jer-lil/relay-bypass/relay-bypass-single-jack/relay-bypass-single-jack.kicad_pcb

## KiCad design relay-bypass-single-jack/relay-bypass-single-jack.kicad_pcb (2026-01-04)

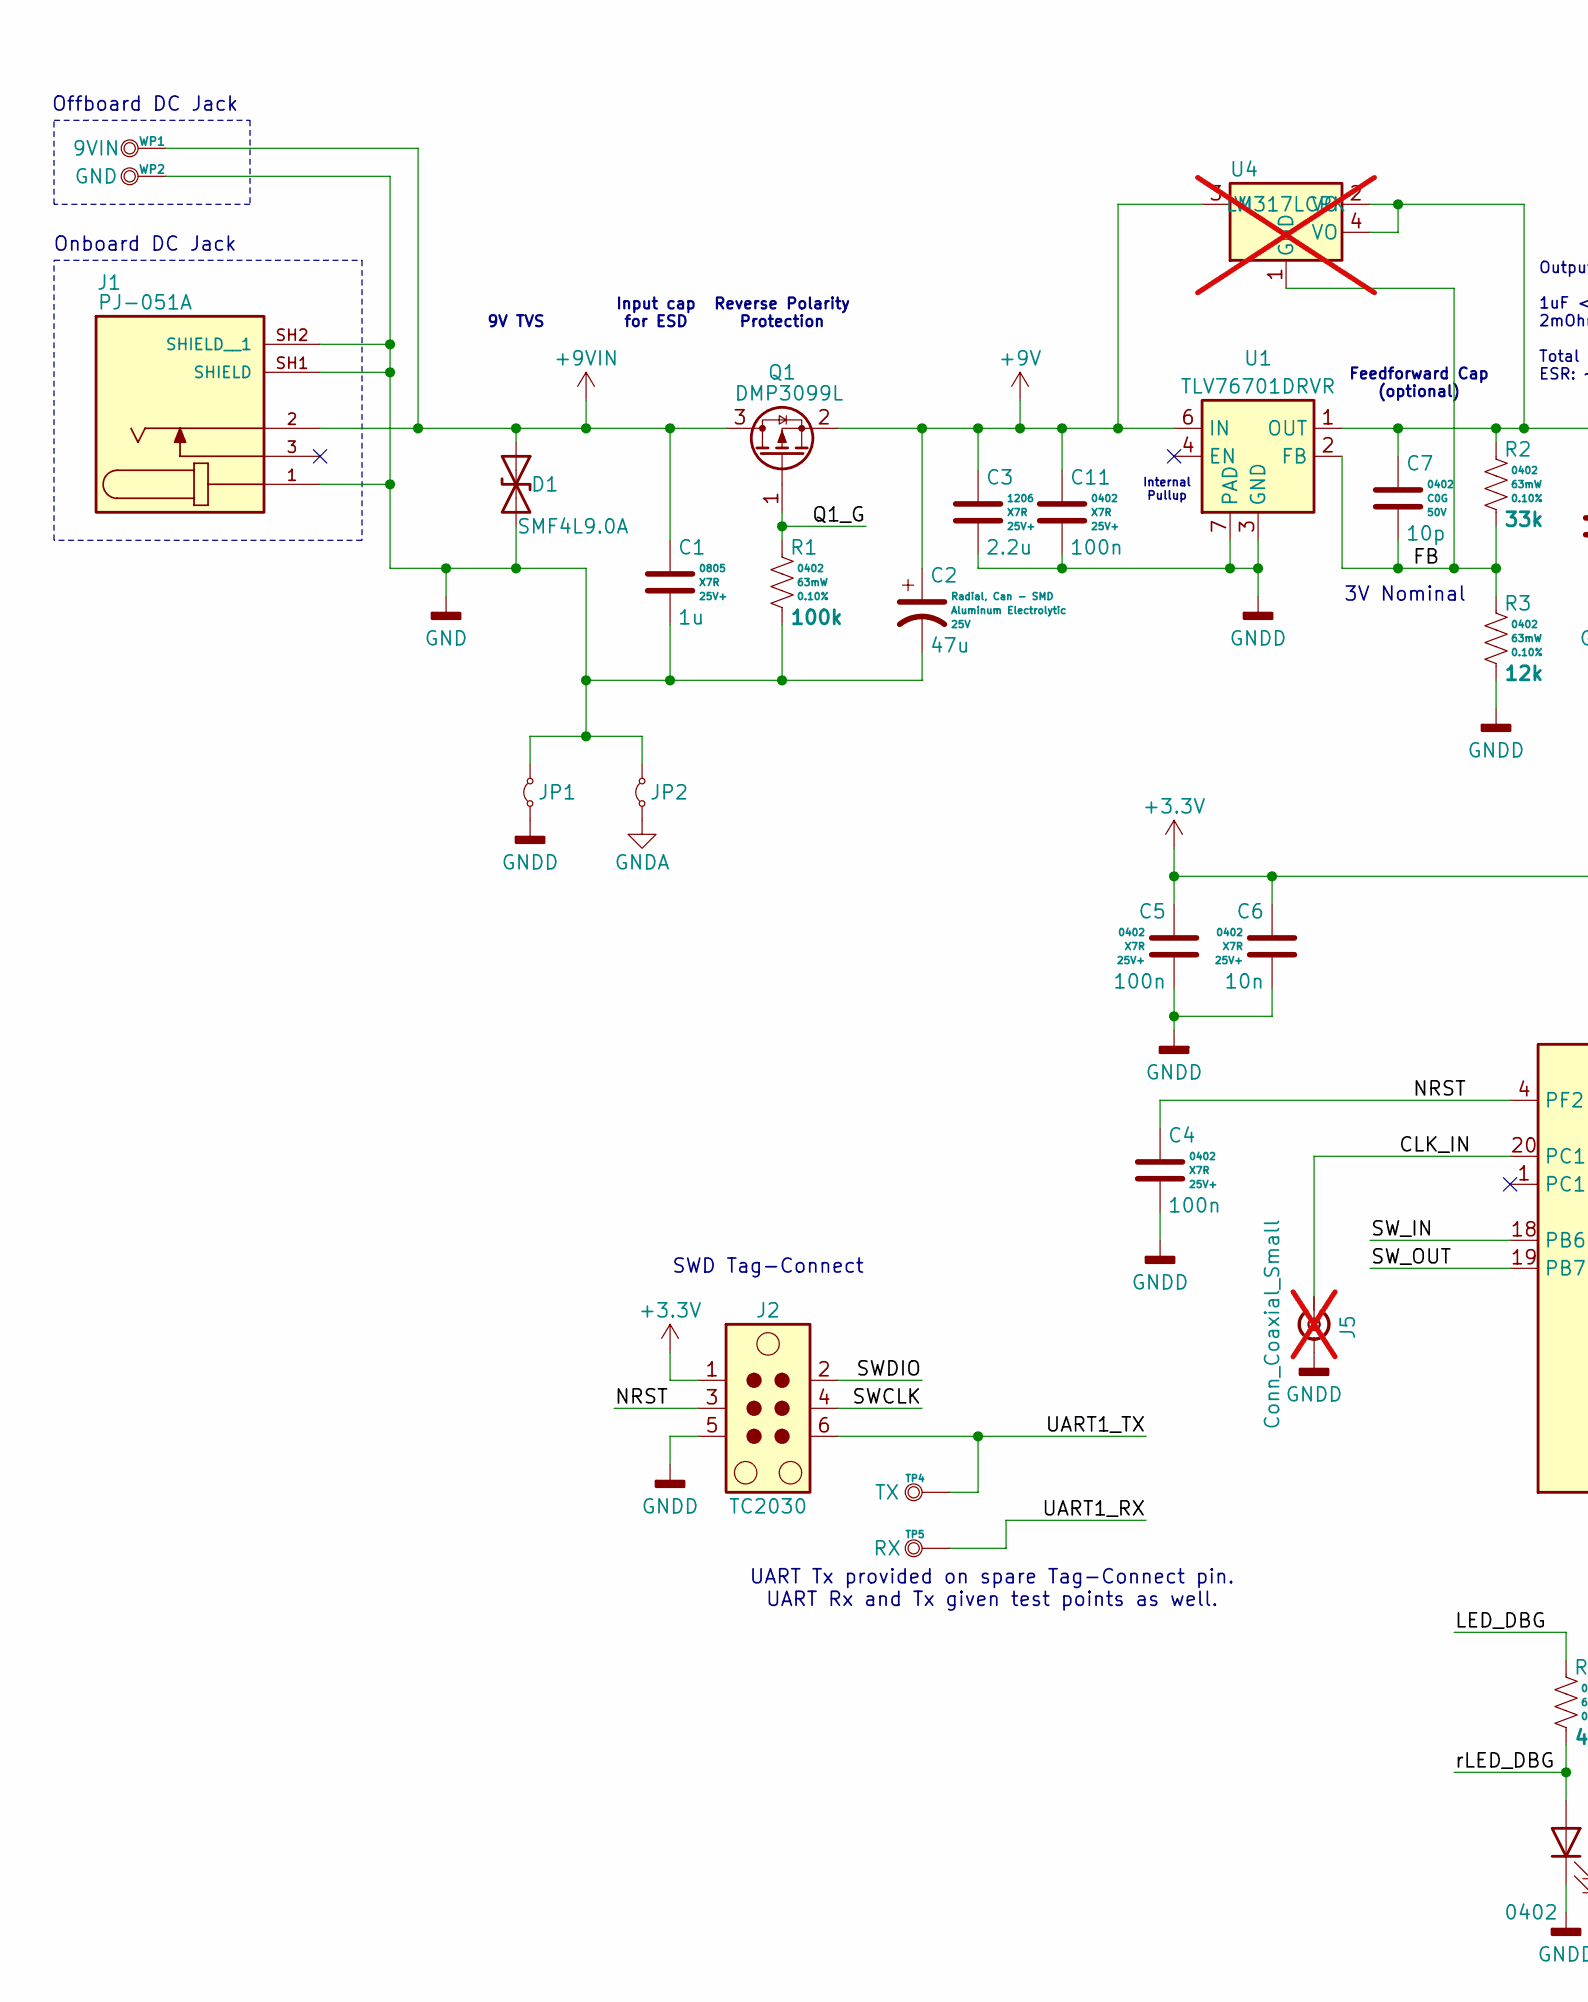
[picture p1: schematic relay-bypass-single-jack.kicad_sch, part in row 1, column 1]

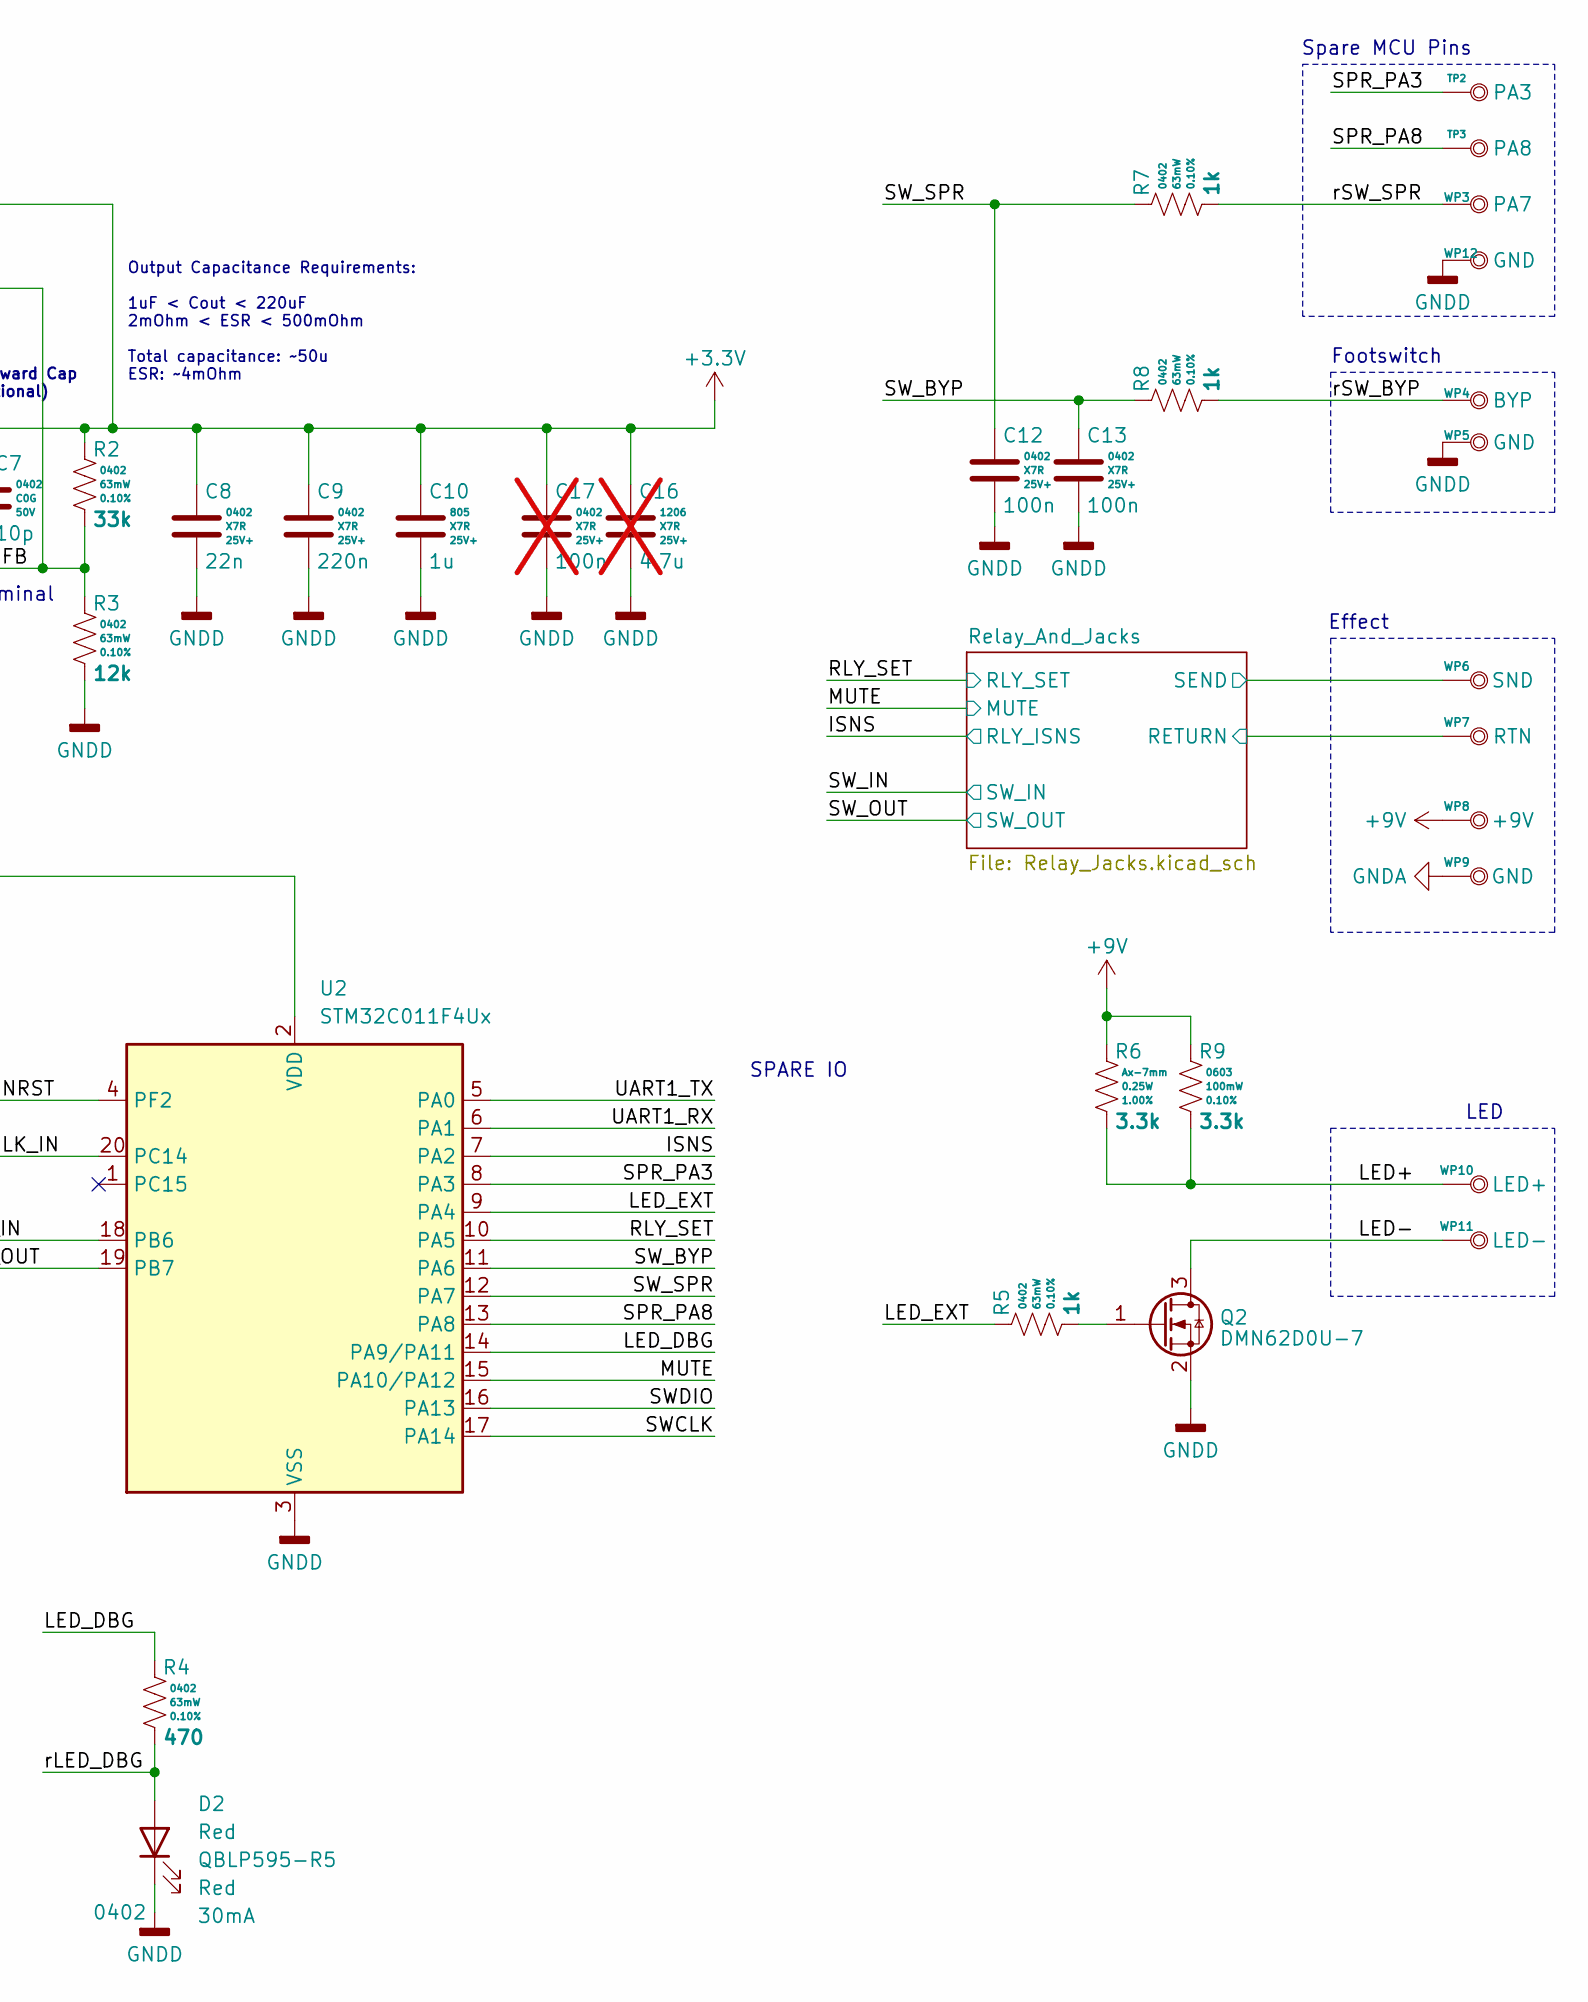
[picture p2: schematic relay-bypass-single-jack.kicad_sch, part in row 1, column 2]

Parts:
C1, C10: 1u; C_0805_2012Metric; Voltage 25V+; Tolerance 10%; MPN C0805C105K3RACTU
C2: 47u; CP_Elec_6.3x5.8; Voltage 25V; Tolerance +/-20%; MPN EEE-FK1E470P
C3: 2.2u; C_1206_3216Metric; Voltage 25V+; Tolerance 10%; MPN C1206C225K3RACTU
C4, C5, C11, C12, C13: 100n; C_0402_1005Metric; Voltage 25V+; Tolerance 10%; MPN C0402C104K3RACTU
C6: 10n; C_0402_1005Metric; Voltage 25V+; Tolerance 10%; MPN C0402C103K3RACTU
C7: 10p; C_0402_1005Metric; Voltage 50V; Tolerance +/-2%; MPN GRM1555C1H100GA01D
C8: 22n; C_0402_1005Metric; Voltage 25V+; Tolerance 10%; MPN C0402C223K3RACTU
C9: 220n; C_0402_1005Metric; Voltage 25V+; Tolerance 10%; MPN C0402C224K3RACTU
C16: 4.7u; C_1206_3216Metric; Voltage 25V+; Tolerance 10%; MPN C1206C475K3RACTU; not fitted
C17: 100n; C_0402_1005Metric; Voltage 25V+; Tolerance 10%; MPN C0402C104K3RACTU; not fitted
D1: SMF4L9.0A; D_SOD-123F; MPN SMF4L9.0A
D2: Red; LED_0402_1005Metric; MPN QBLP595-R5
J1: 3; BarrelJack_CUI_PJ-051A; PARTREV 1.06
J2: TC2030; Tag-Connect_TC2030-IDC-NL_2x03_P1.27mm_Vertical
J5: Conn_Coaxial_Small; U.FL_Hirose_U.FL-R-SMT-1_Vertical; not fitted
JP1, JP2: Jumper_2_Small_Bridged; SolderJumper-2_P1.3mm_Bridged2Bar_Pad1.0x1.5mm
Q1: DMP3099L; SOT-23; MPN DMP3099L
Q2: DMN62D0U-7; SOT-23; MPN DMN62D0U-7
R1: 100k; R_0402_1005Metric; Tolerance 0.10%; Voltage 50V; MPN RT0402BRD07100KL
R2: 33k; R_0402_1005Metric; Tolerance 0.10%; Voltage 50V; MPN RT0402BRD0733KL
R3: 12k; R_0402_1005Metric; Tolerance 0.10%; Voltage 50V; MPN RT0402BRD0712KL
R4: 470; R_0402_1005Metric; Tolerance 0.10%; Voltage 50V; MPN RT0402BRD07470RL
R5, R7, R8: 1k; R_0402_1005Metric; Tolerance 0.10%; Voltage 50V; MPN RT0402BRD071KL
R6: 3.3k; R_Axial_DIN0207_L6.3mm_D2.5mm_P7.5mm_Horizontal; Tolerance 1.00%; Voltage 250V; MPN MFR-25FBF52-3K3
R9: 3.3k; R_0603_1608Metric; Tolerance 0.10%; Voltage 75V; MPN RT0603BRD073K3L
TP2: PA3; TestPoint_PTH_H1.02mm_NoOutline
TP3: PA8; TestPoint_PTH_H1.02mm_NoOutline
TP4: TX; TestPoint_PTH_H1.02mm_NoOutline
TP5: RX; TestPoint_PTH_H1.02mm_NoOutline
U1: TLV76701DRVR; WSON-6-1EP_2x2mm_P0.65mm_EP1x1.6mm; Voltage ADJ; MPN TLV76701DRVR
U2: STM32C011F4Ux; ST_UFQFPN-20_3x3mm_P0.5mm
U4: LM317LCPK; SOT-223; Voltage ADJ; MPN LM317LCPK; not fitted
WP1: 9VIN; WirePad_H0.95mm_22-24AWG
WP2, WP5, WP9, WP12: GND; WirePad_H0.95mm_22-24AWG
WP3: PA7; WirePad_H0.95mm_22-24AWG
WP4: BYP; WirePad_H0.95mm_22-24AWG
WP6: SND; WirePad_H0.95mm_22-24AWG
WP7: RTN; WirePad_H0.95mm_22-24AWG
WP8: +9V; WirePad_H0.95mm_22-24AWG
WP10: LED+; WirePad_H0.95mm_22-24AWG
WP11: LED-; WirePad_H0.95mm_22-24AWG

Connections:
+3.3V: C5.1, C6.1, C7.1, C8.1, C9.1, C10.1, C16.1, C17.1, J2.1, R2.1, U1.1 (OUT), U2.2 (VDD), U4.2 (VO), U4.4 (VO); also elsewhere on the board
+9V: C2.1, C3.1, C11.1, Q1.2 (S), R6.1, R9.1, U1.6 (IN), U4.3 (VI), WP8.1; also elsewhere on the board
+9VIN: C1.1, D1.1 (A1), J1.2, Q1.3 (D), WP1.1
/CLK_IN: J5.1 (In), U2.20 (PC14)
/FB: C7.2, R2.2, R3.1, U1.2 (FB), U4.1 (GND)
/ISNS: U2.7 (PA2); also elsewhere on the board
/LED+: R6.2, R9.2, WP10.1
/LED-: Q2.3 (D), WP11.1
/LED_DBG: R4.1, U2.14 (PA9/PA11)
/LED_EXT: R5.1, U2.9 (PA4)
/MUTE: U2.15 (PA10/PA12); also elsewhere on the board
/NRST: C4.1, J2.3, U2.4 (PF2)
/Q1_G: Q1.1 (G), R1.1
/RLY_SET: U2.10 (PA5); also elsewhere on the board
/Relay_And_Jacks/RETURN: WP7.1; also elsewhere on the board
/Relay_And_Jacks/SEND: WP6.1; also elsewhere on the board
/SPR_PA3: TP2.1, U2.8 (PA3)
/SPR_PA8: TP3.1, U2.13 (PA8)
/SWCLK: J2.4, U2.17 (PA14)
/SWDIO: J2.2, U2.16 (PA13)
/SW_BYP: C13.1, R8.1, U2.11 (PA6)
/SW_IN: U2.18 (PB6); also elsewhere on the board
/SW_OUT: U2.19 (PB7); also elsewhere on the board
/SW_SPR: C12.1, R7.1, U2.12 (PA7)
/UART1_RX: TP5.1, U2.6 (PA1)
/UART1_TX: J2.6, TP4.1, U2.5 (PA0)
/rLED_DBG: D2.2 (A), R4.2
/rSW_BYP: R8.2, WP4.1
/rSW_SPR: R7.2, WP3.1
GND: C1.2, C2.2, D1.2 (A2), J1.1, J1.SH1 (SHIELD), J1.SH2 (SHIELD__1), JP1.2 (B), JP2.2 (B), R1.2, WP2.1
GNDA: JP2.1 (A), WP9.1; also elsewhere on the board
GNDD: C3.2, C4.2, C5.2, C6.2, C8.2, C9.2, C10.2, C11.2, C12.2, C13.2, C16.2, C17.2, D2.1 (K), J2.5, J5.2 (Ext), JP1.1 (A), Q2.2 (S), R3.2, U1.3 (GND), U1.5 (GND), U1.7 (PAD), U2.3 (VSS), WP5.1, WP12.1; also elsewhere on the board
unnamed: Q2.1 (G), R5.2

Notes on the sheet:
Input cap for ESD
SWD Tag-Connect
Spare MCU Pins
Effect
9V TVS
Reverse Polarity Protection
3V Nominal
Output Capacitance Requirements: 1uF < Cout < 220uF 2mOhm < ESR < 500mOhm Total capacitance: ~50u ESR: ~4mOhm
LED
Footswitch
Feedforward Cap (optional)
SPARE IO
Onboard DC Jack
Internal Pullup
UART Tx provided on spare Tag-Connect pin. UART Rx and Tx given test points as well.
Offboard DC Jack

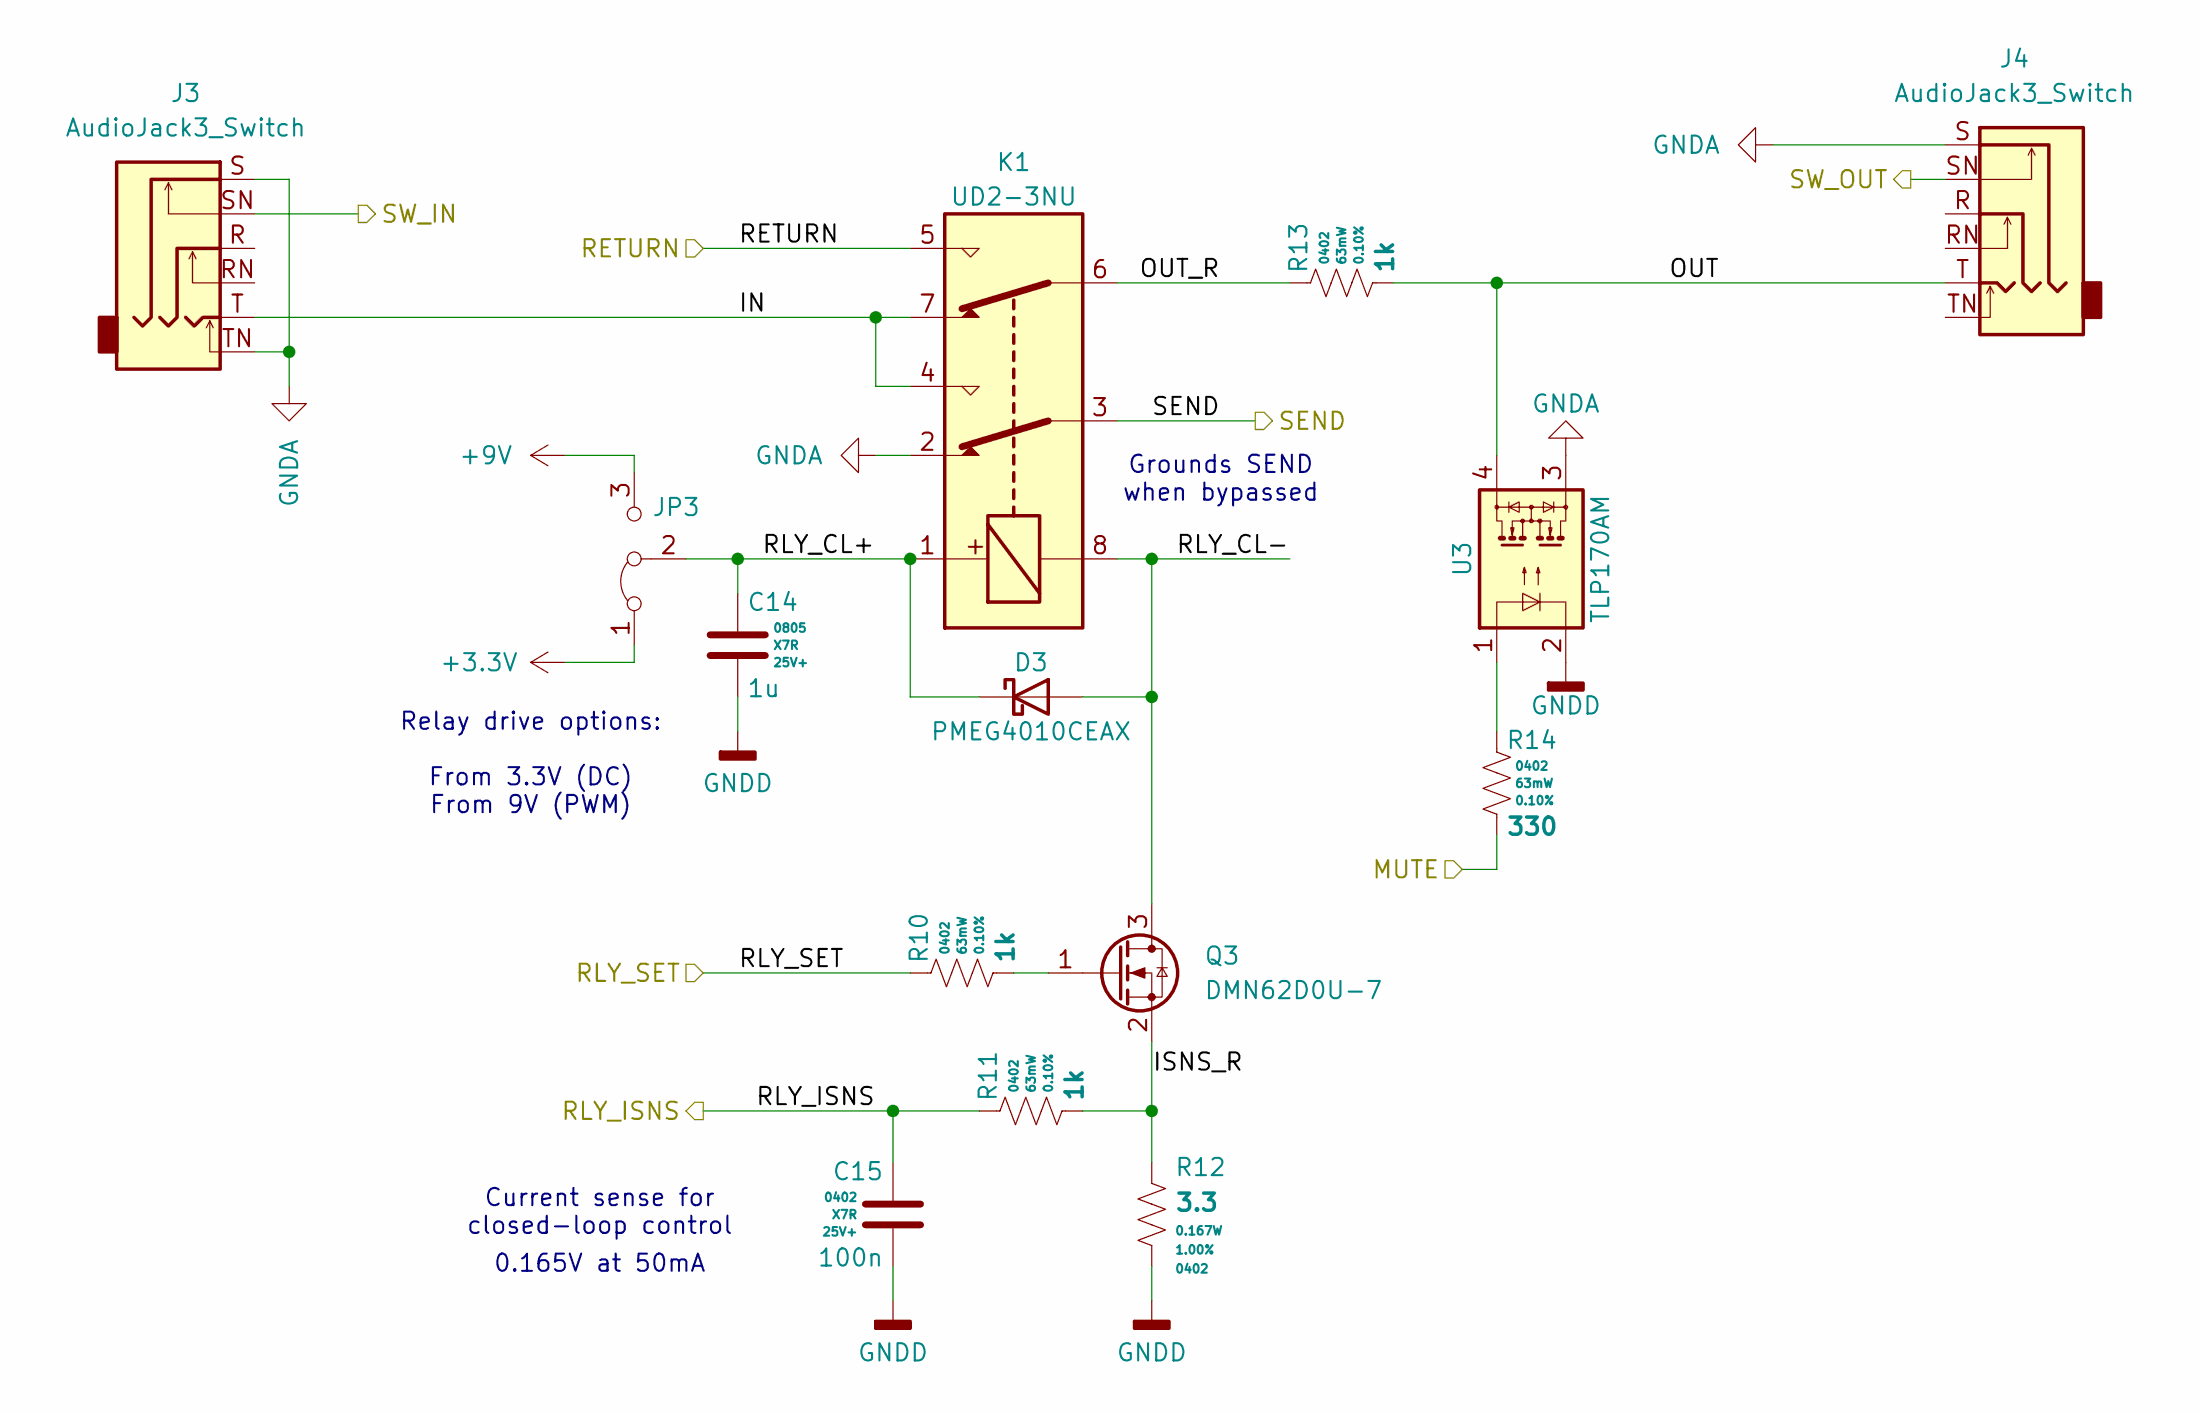
[picture p3: schematic Relay_Jacks.kicad_sch]

Parts:
C14: 1u; C_0805_2012Metric; Voltage 25V+; Tolerance 10%; MPN C0805C105K3RACTU
C15: 100n; C_0402_1005Metric; Voltage 25V+; Tolerance 10%; MPN C0402C104K3RACTU
D3: PMEG4010CEAX; D_SOD-323; Voltage 840 mV @ 1 A; MPN PMEG4010CEAX
J3, J4: AudioJack3_Switch; Jack_6.35mm_Neutrik_NMJ6HCD2_LARGE_SLOTS
JP3: Jumper_3_Bridged12; SolderJumper-3_P1.3mm_Bridged12_Pad1.0x1.5mm
K1: IM05JR; UD23NU; MPN UD2-3NU
Q3: DMN62D0U-7; SOT-23; MPN DMN62D0U-7
R10, R11, R13: 1k; R_0402_1005Metric; Tolerance 0.10%; Voltage 50V; MPN RT0402BRD071KL
R12: 3.3; R_0402_1005Metric; Tolerance 1.00%; Voltage 50V; MPN RL0510S-3R3-F
R14: 330; R_0402_1005Metric; Tolerance 0.10%; Voltage 50V; MPN RT0402BRD07330RL
U3: TLP170AM; SO-4_4.4x3.9mm_P2.54mm; MPN TLP170AM

Connections:
+3.3V: JP3.1 (A); also elsewhere on the board
+9V: JP3.3 (B); also elsewhere on the board
/ISNS: C15.1, R11.1; also elsewhere on the board
/MUTE: R14.2; also elsewhere on the board
/RLY_SET: R10.1; also elsewhere on the board
/Relay_And_Jacks/IN: J3.T, K1.4, K1.7
/Relay_And_Jacks/ISNS_R: Q3.2 (S), R11.2, R12.1
/Relay_And_Jacks/OUT: J4.T, R13.2, U3.4
/Relay_And_Jacks/OUT_R: K1.6, R13.1
/Relay_And_Jacks/RETURN: K1.5; also elsewhere on the board
/Relay_And_Jacks/RLY_CL+: C14.1, D3.1 (K), JP3.2 (C), K1.1
/Relay_And_Jacks/RLY_CL-: D3.2 (A), K1.8, Q3.3 (D)
/Relay_And_Jacks/SEND: K1.3; also elsewhere on the board
/SW_IN: J3.SN; also elsewhere on the board
/SW_OUT: J4.SN; also elsewhere on the board
GNDA: J3.S, J3.TN, J4.S, K1.2, U3.3; also elsewhere on the board
GNDD: C14.2, C15.2, R12.2, U3.2; also elsewhere on the board
unnamed: Q3.1 (G), R10.2
unnamed: R14.1, U3.1

Notes on the sheet:
Current sense for closed-loop control
Grounds SEND when bypassed
Relay drive options: From 3.3V (DC) From 9V (PWM)
0.165V at 50mA

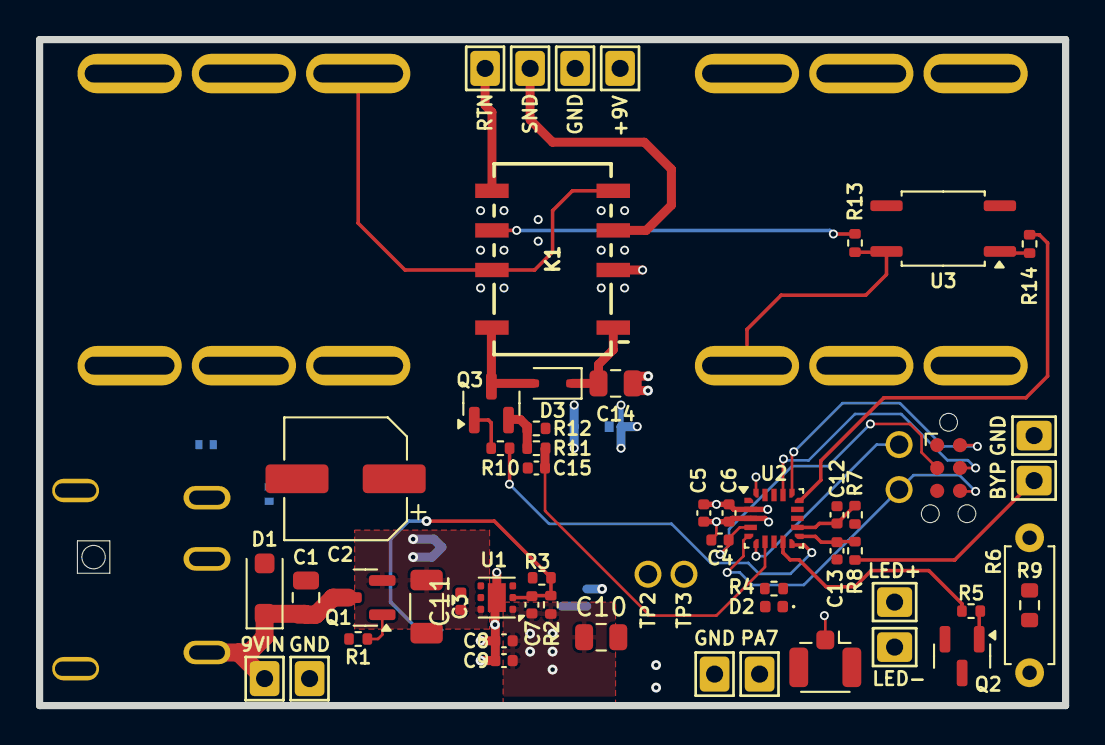
[picture p4: board relay-bypass-single-jack.kicad_pcb from above]

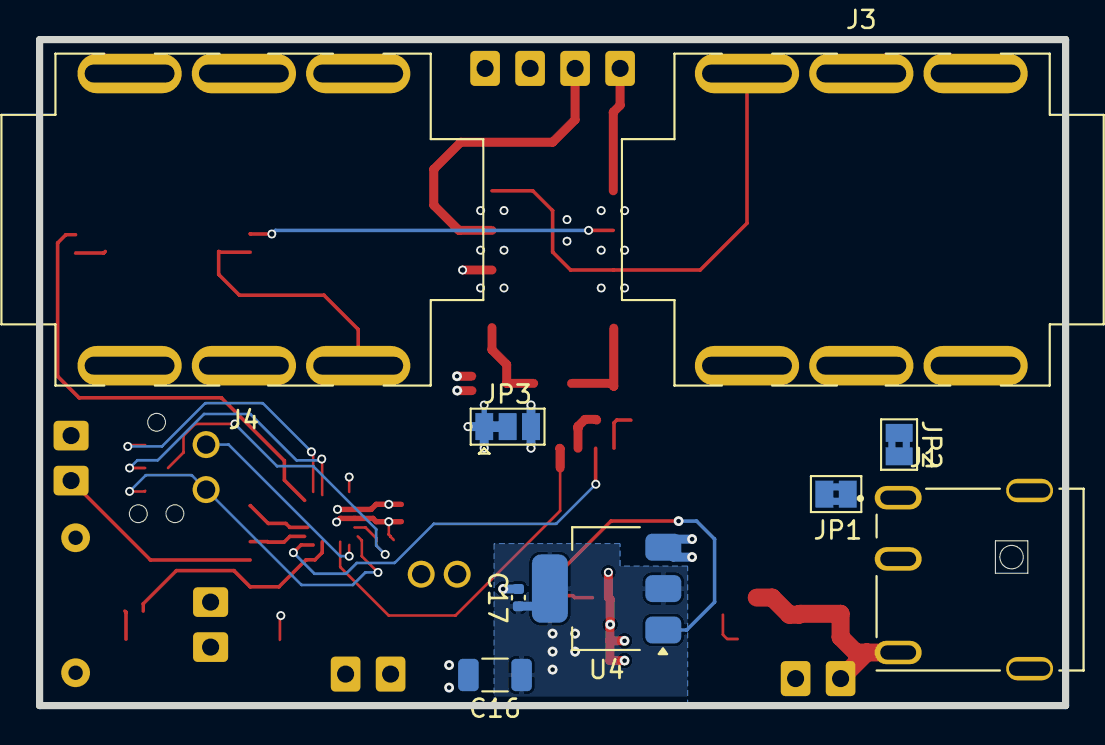
[picture p5: board relay-bypass-single-jack.kicad_pcb from below]

Board: 4 copper layers, 57.0 x 37.0 mm, 66 parts (9 on the bottom side), 41 nets.
