jer-lil/relay-bypass/relay-bypass.kicad_pcb

## KiCad design relay-bypass.kicad_pcb (2025-09-01)

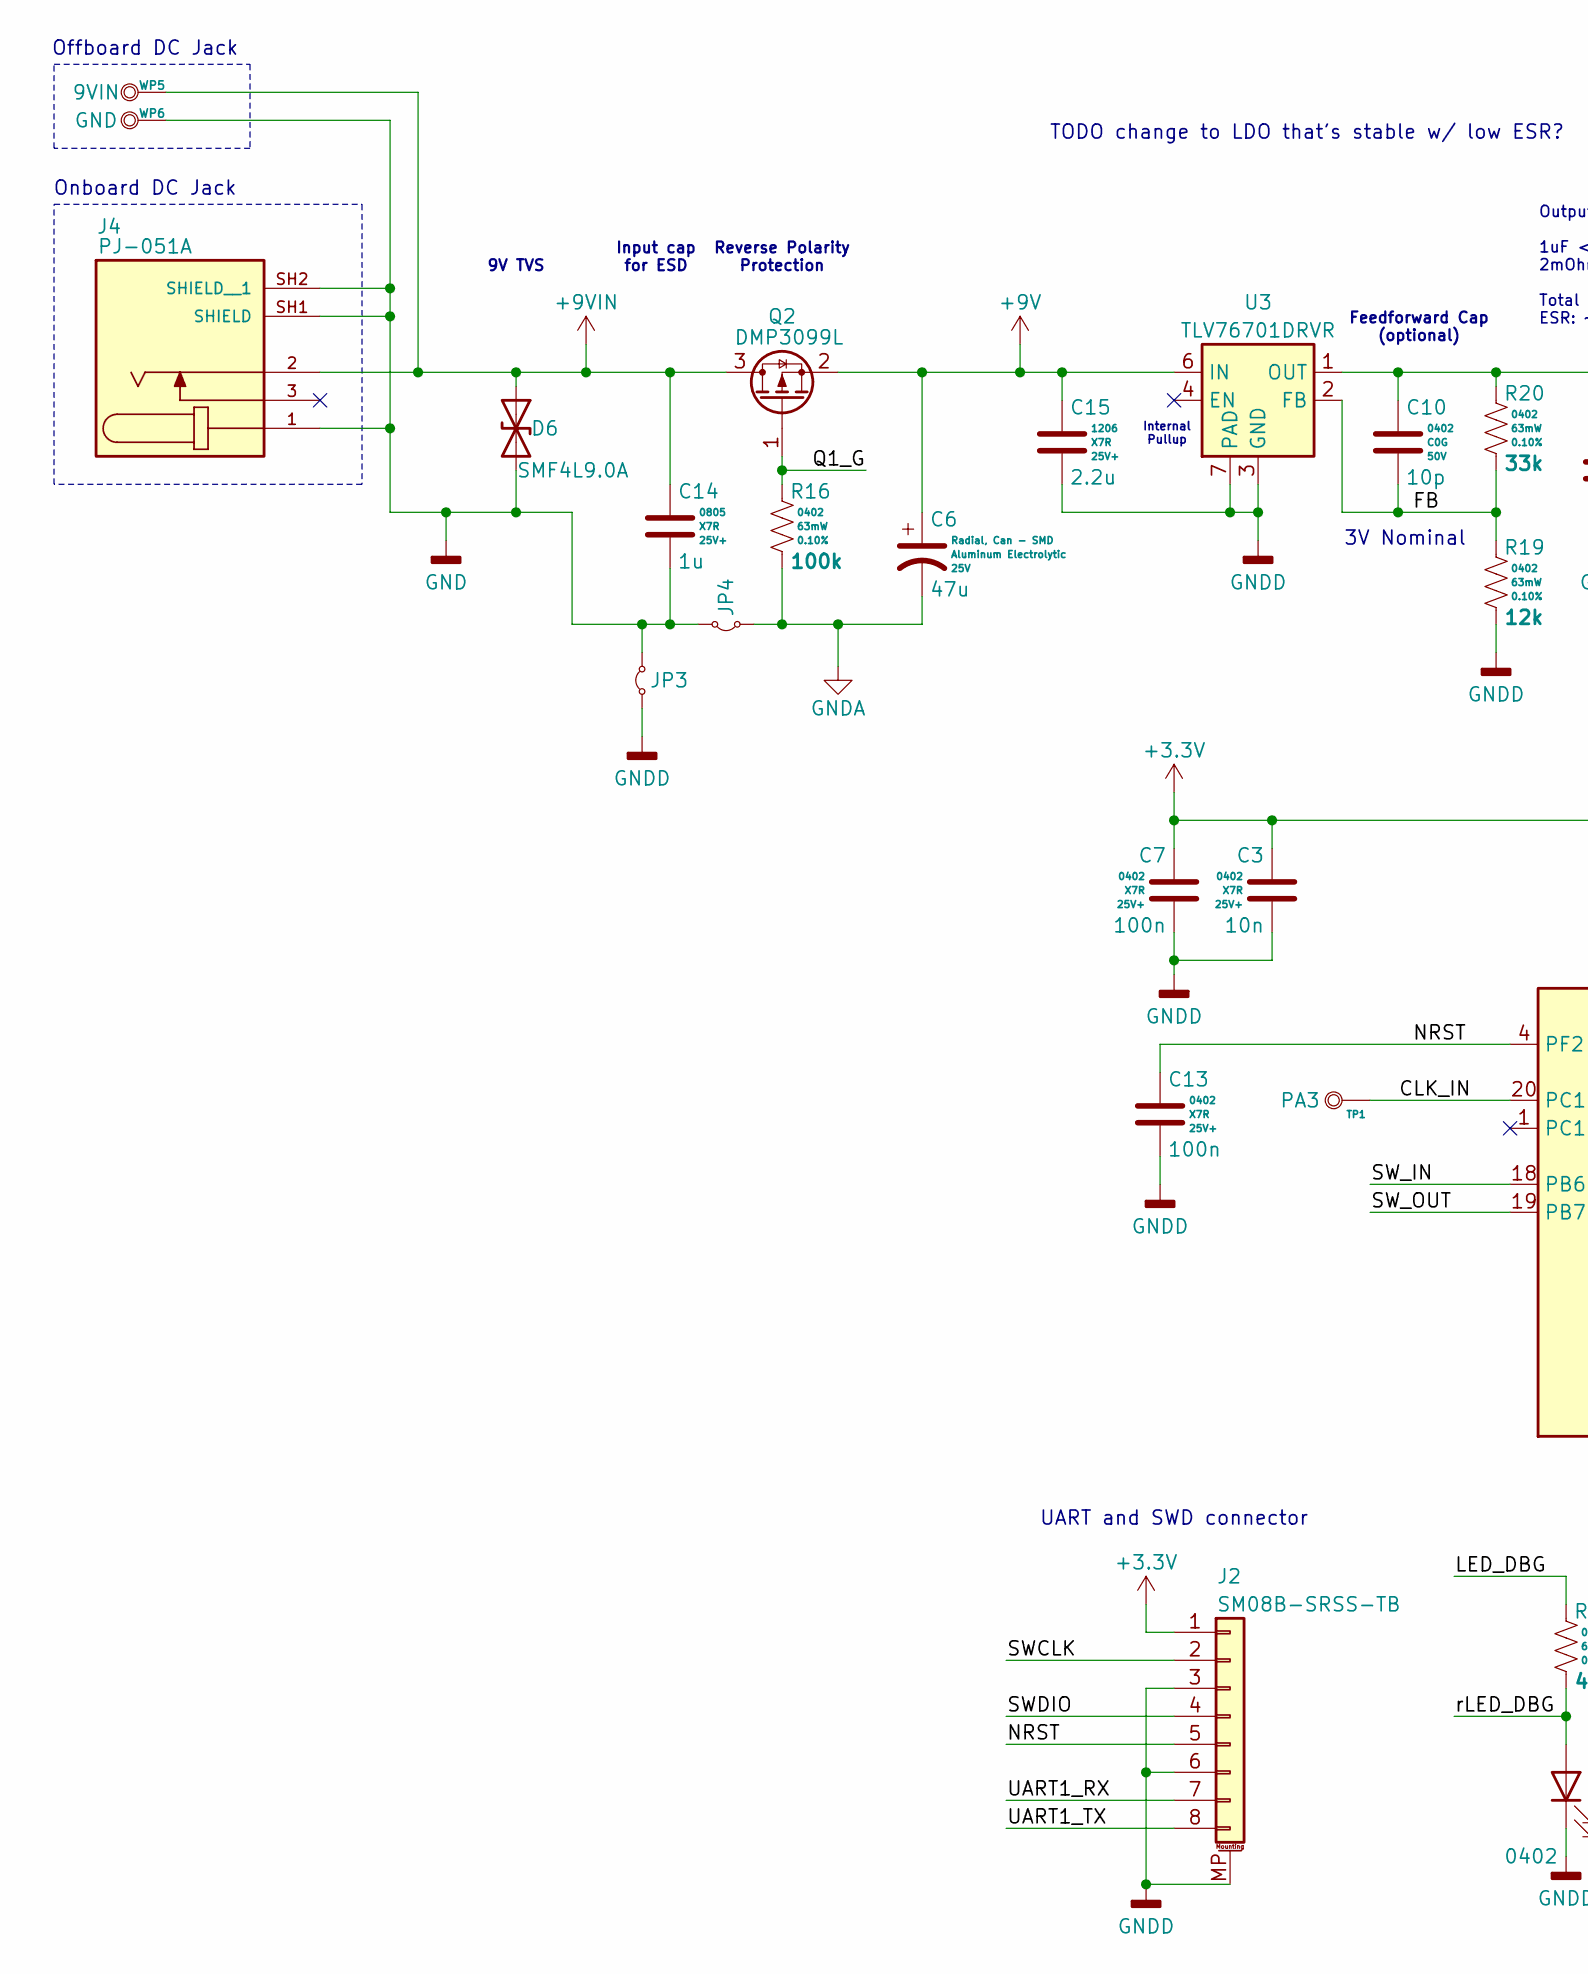
[picture p6: schematic relay-bypass.kicad_sch, part in row 1, column 1]

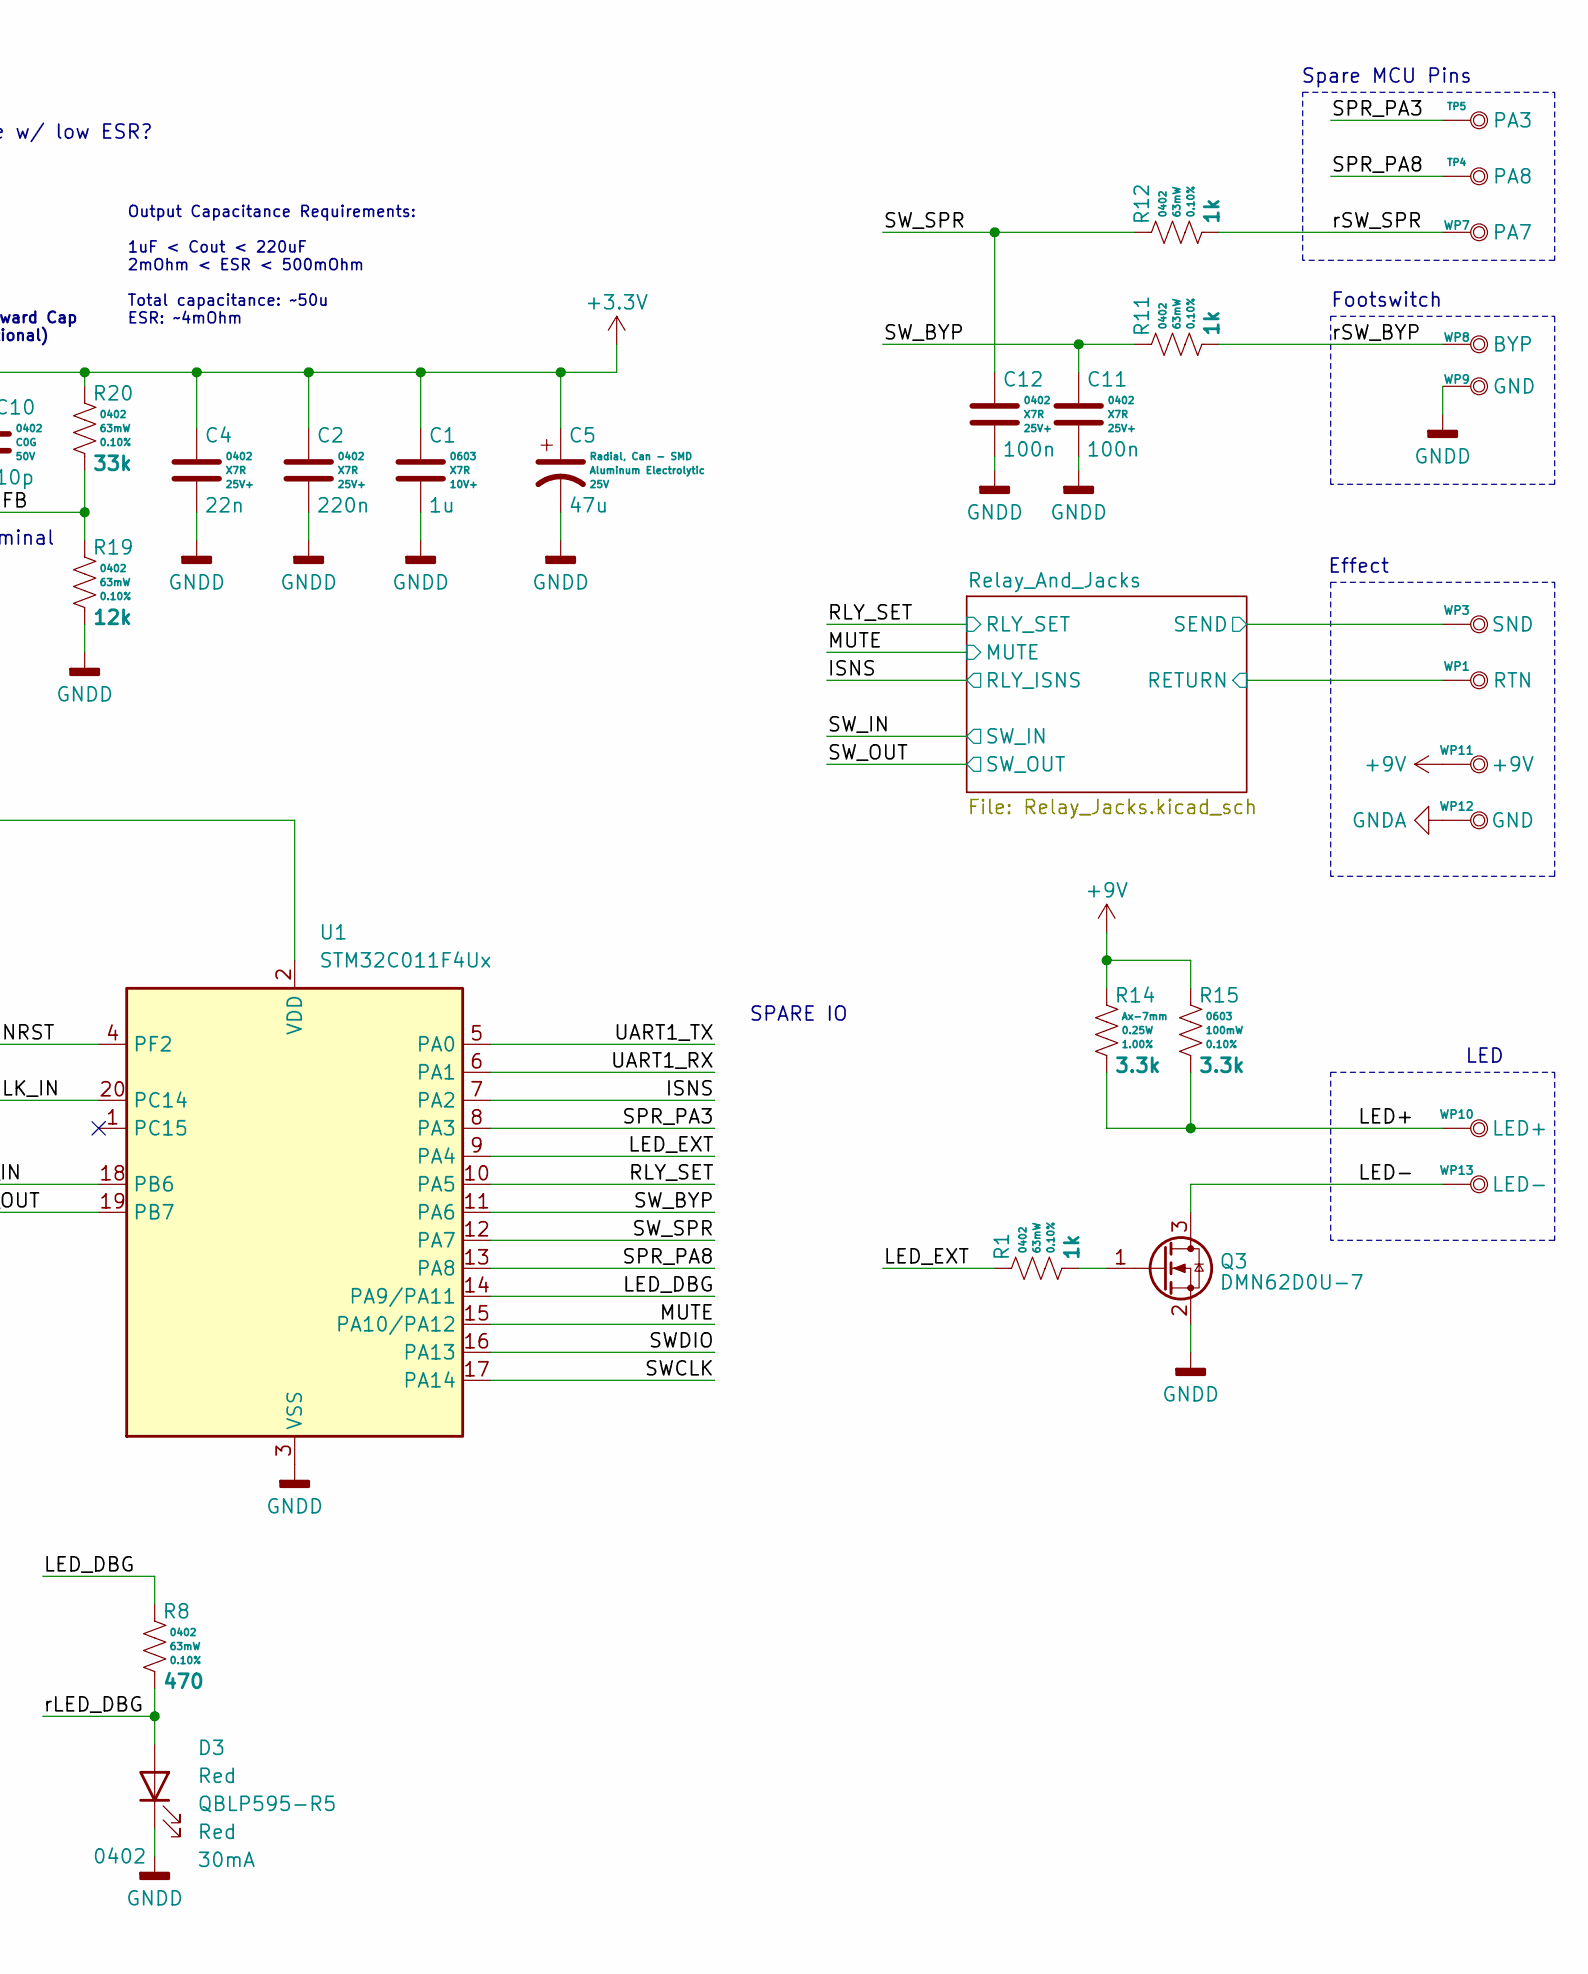
[picture p7: schematic relay-bypass.kicad_sch, part in row 1, column 2]

Parts:
C1: 1u; C_0603_1608Metric; Voltage 10V+; Tolerance 10%; MPN C0603C105K8RACTU
C2: 220n; C_0402_1005Metric; Voltage 25V+; Tolerance 10%; MPN C0402C224K3RACTU
C3: 10n; C_0402_1005Metric; Voltage 25V+; Tolerance 10%; MPN C0402C103K3RACTU
C4: 22n; C_0402_1005Metric; Voltage 25V+; Tolerance 10%; MPN C0402C223K3RACTU
C5, C6: 47u; CP_Elec_6.3x5.8; Voltage 25V; Tolerance +/-20%; MPN EEE-FK1E470P
C7, C11, C12, C13: 100n; C_0402_1005Metric; Voltage 25V+; Tolerance 10%; MPN C0402C104K3RACTU
C10: 10p; C_0402_1005Metric; Voltage 50V; Tolerance +/-2%; MPN GRM1555C1H100GA01D
C14: 1u; C_0805_2012Metric; Voltage 25V+; Tolerance 10%; MPN C0805C105K3RACTU
C15: 2.2u; C_1206_3216Metric; Voltage 25V+; Tolerance 10%; MPN C1206C225K3RACTU
D3: Red; LED_0402_1005Metric; MPN QBLP595-R5
D6: SMF4L9.0A; D_SOD-123F; MPN SMF4L9.0A
J2: 8; JST_SH_BM08B-SRSS-TB_1x08-1MP_P1.00mm_Vertical; MPN SM08B-SRSS-TB
J4: 3; BarrelJack_CUI_PJ-051A; PARTREV 1.06
JP3, JP4: Jumper_2_Small_Bridged; SolderJumper-2_P1.3mm_Bridged2Bar_Pad1.0x1.5mm
Q2: DMP3099L; SOT-23; MPN DMP3099L
Q3: DMN62D0U-7; SOT-23; MPN DMN62D0U-7
R1, R11, R12: 1k; R_0402_1005Metric; Tolerance 0.10%; Voltage 50V; MPN RT0402BRD071KL
R8: 470; R_0402_1005Metric; Tolerance 0.10%; Voltage 50V; MPN RT0402BRD07470RL
R14: 3.3k; R_Axial_DIN0207_L6.3mm_D2.5mm_P7.5mm_Horizontal; Tolerance 1.00%; Voltage 250V; MPN MFR-25FBF52-3K3
R15: 3.3k; R_0603_1608Metric; Tolerance 0.10%; Voltage 75V; MPN RT0603BRD073K3L
R16: 100k; R_0402_1005Metric; Tolerance 0.10%; Voltage 50V; MPN RT0402BRD07100KL
R19: 12k; R_0402_1005Metric; Tolerance 0.10%; Voltage 50V; MPN RT0402BRD0712KL
R20: 33k; R_0402_1005Metric; Tolerance 0.10%; Voltage 50V; MPN RT0402BRD0733KL
TP1, TP5: PA3; TestPoint_PTH_H1.02mm_NoOutline
TP4: PA8; TestPoint_PTH_H1.02mm_NoOutline
U1: STM32C011F4Ux; ST_UFQFPN-20_3x3mm_P0.5mm
U3: TLV76701DRVR; WSON-6-1EP_2x2mm_P0.65mm_EP1x1.6mm; Voltage ADJ; MPN TLV76701DRVR
WP1: RTN; WirePad_H0.95mm_22-24AWG
WP3: SND; WirePad_H0.95mm_22-24AWG
WP5: 9VIN; WirePad_H0.95mm_22-24AWG
WP6, WP9, WP12: GND; WirePad_H0.95mm_22-24AWG
WP7: PA7; WirePad_H0.95mm_22-24AWG
WP8: BYP; WirePad_H0.95mm_22-24AWG
WP10: LED+; WirePad_H0.95mm_22-24AWG
WP11: +9V; WirePad_H0.95mm_22-24AWG
WP13: LED-; WirePad_H0.95mm_22-24AWG

Connections:
+3.3V: C1.1, C2.1, C3.1, C4.1, C5.1, C7.1, C10.1, J2.1, R20.1, U1.2 (VDD), U3.1 (OUT); also elsewhere on the board
+9V: C6.1, C15.1, Q2.2 (S), R14.1, R15.1, U3.6 (IN), WP11.1; also elsewhere on the board
+9VIN: C14.1, D6.1 (A1), J4.2, Q2.3 (D), WP5.1
/CLK_IN: TP1.1, U1.20 (PC14)
/FB: C10.2, R19.1, R20.2, U3.2 (FB)
/ISNS: U1.7 (PA2); also elsewhere on the board
/LED+: R14.2, R15.2, WP10.1
/LED-: Q3.3 (D), WP13.1
/LED_DBG: R8.1, U1.14 (PA9/PA11)
/LED_EXT: R1.1, U1.9 (PA4)
/MUTE: U1.15 (PA10/PA12); also elsewhere on the board
/NRST: C13.1, J2.5, U1.4 (PF2)
/Q1_G: Q2.1 (G), R16.1
/RLY_SET: U1.10 (PA5); also elsewhere on the board
/Relay_And_Jacks/RETURN: WP1.1; also elsewhere on the board
/Relay_And_Jacks/SEND: WP3.1; also elsewhere on the board
/SPR_PA3: TP5.1, U1.8 (PA3)
/SPR_PA8: TP4.1, U1.13 (PA8)
/SWCLK: J2.2, U1.17 (PA14)
/SWDIO: J2.4, U1.16 (PA13)
/SW_BYP: C11.1, R11.1, U1.11 (PA6)
/SW_IN: U1.18 (PB6); also elsewhere on the board
/SW_OUT: U1.19 (PB7); also elsewhere on the board
/SW_SPR: C12.1, R12.1, U1.12 (PA7)
/UART1_RX: J2.7, U1.6 (PA1)
/UART1_TX: J2.8, U1.5 (PA0)
/rLED_DBG: D3.2 (A), R8.2
/rSW_BYP: R11.2, WP8.1
/rSW_SPR: R12.2, WP7.1
GND: C14.2, D6.2 (A2), J4.1, J4.SH1 (SHIELD), J4.SH2 (SHIELD__1), JP3.2 (B), JP4.2 (B), WP6.1
GNDA: C6.2, JP4.1 (A), R16.2, WP12.1; also elsewhere on the board
GNDD: C1.2, C2.2, C3.2, C4.2, C5.2, C7.2, C11.2, C12.2, C13.2, C15.2, D3.1 (K), J2.3, J2.6, J2.MP (MountPin), JP3.1 (A), Q3.2 (S), R19.2, U1.3 (VSS), U3.3 (GND), U3.5 (GND), U3.7 (PAD), WP9.1; also elsewhere on the board
unnamed: Q3.1 (G), R1.2

Notes on the sheet:
Input cap for ESD
UART and SWD connector
Spare MCU Pins
Effect
9V TVS
TODO change to LDO that's stable w/ low ESR?
Reverse Polarity Protection
3V Nominal
Output Capacitance Requirements: 1uF < Cout < 220uF 2mOhm < ESR < 500mOhm Total capacitance: ~50u ESR: ~4mOhm
LED
Footswitch
Feedforward Cap (optional)
SPARE IO
Onboard DC Jack
Internal Pullup
Offboard DC Jack

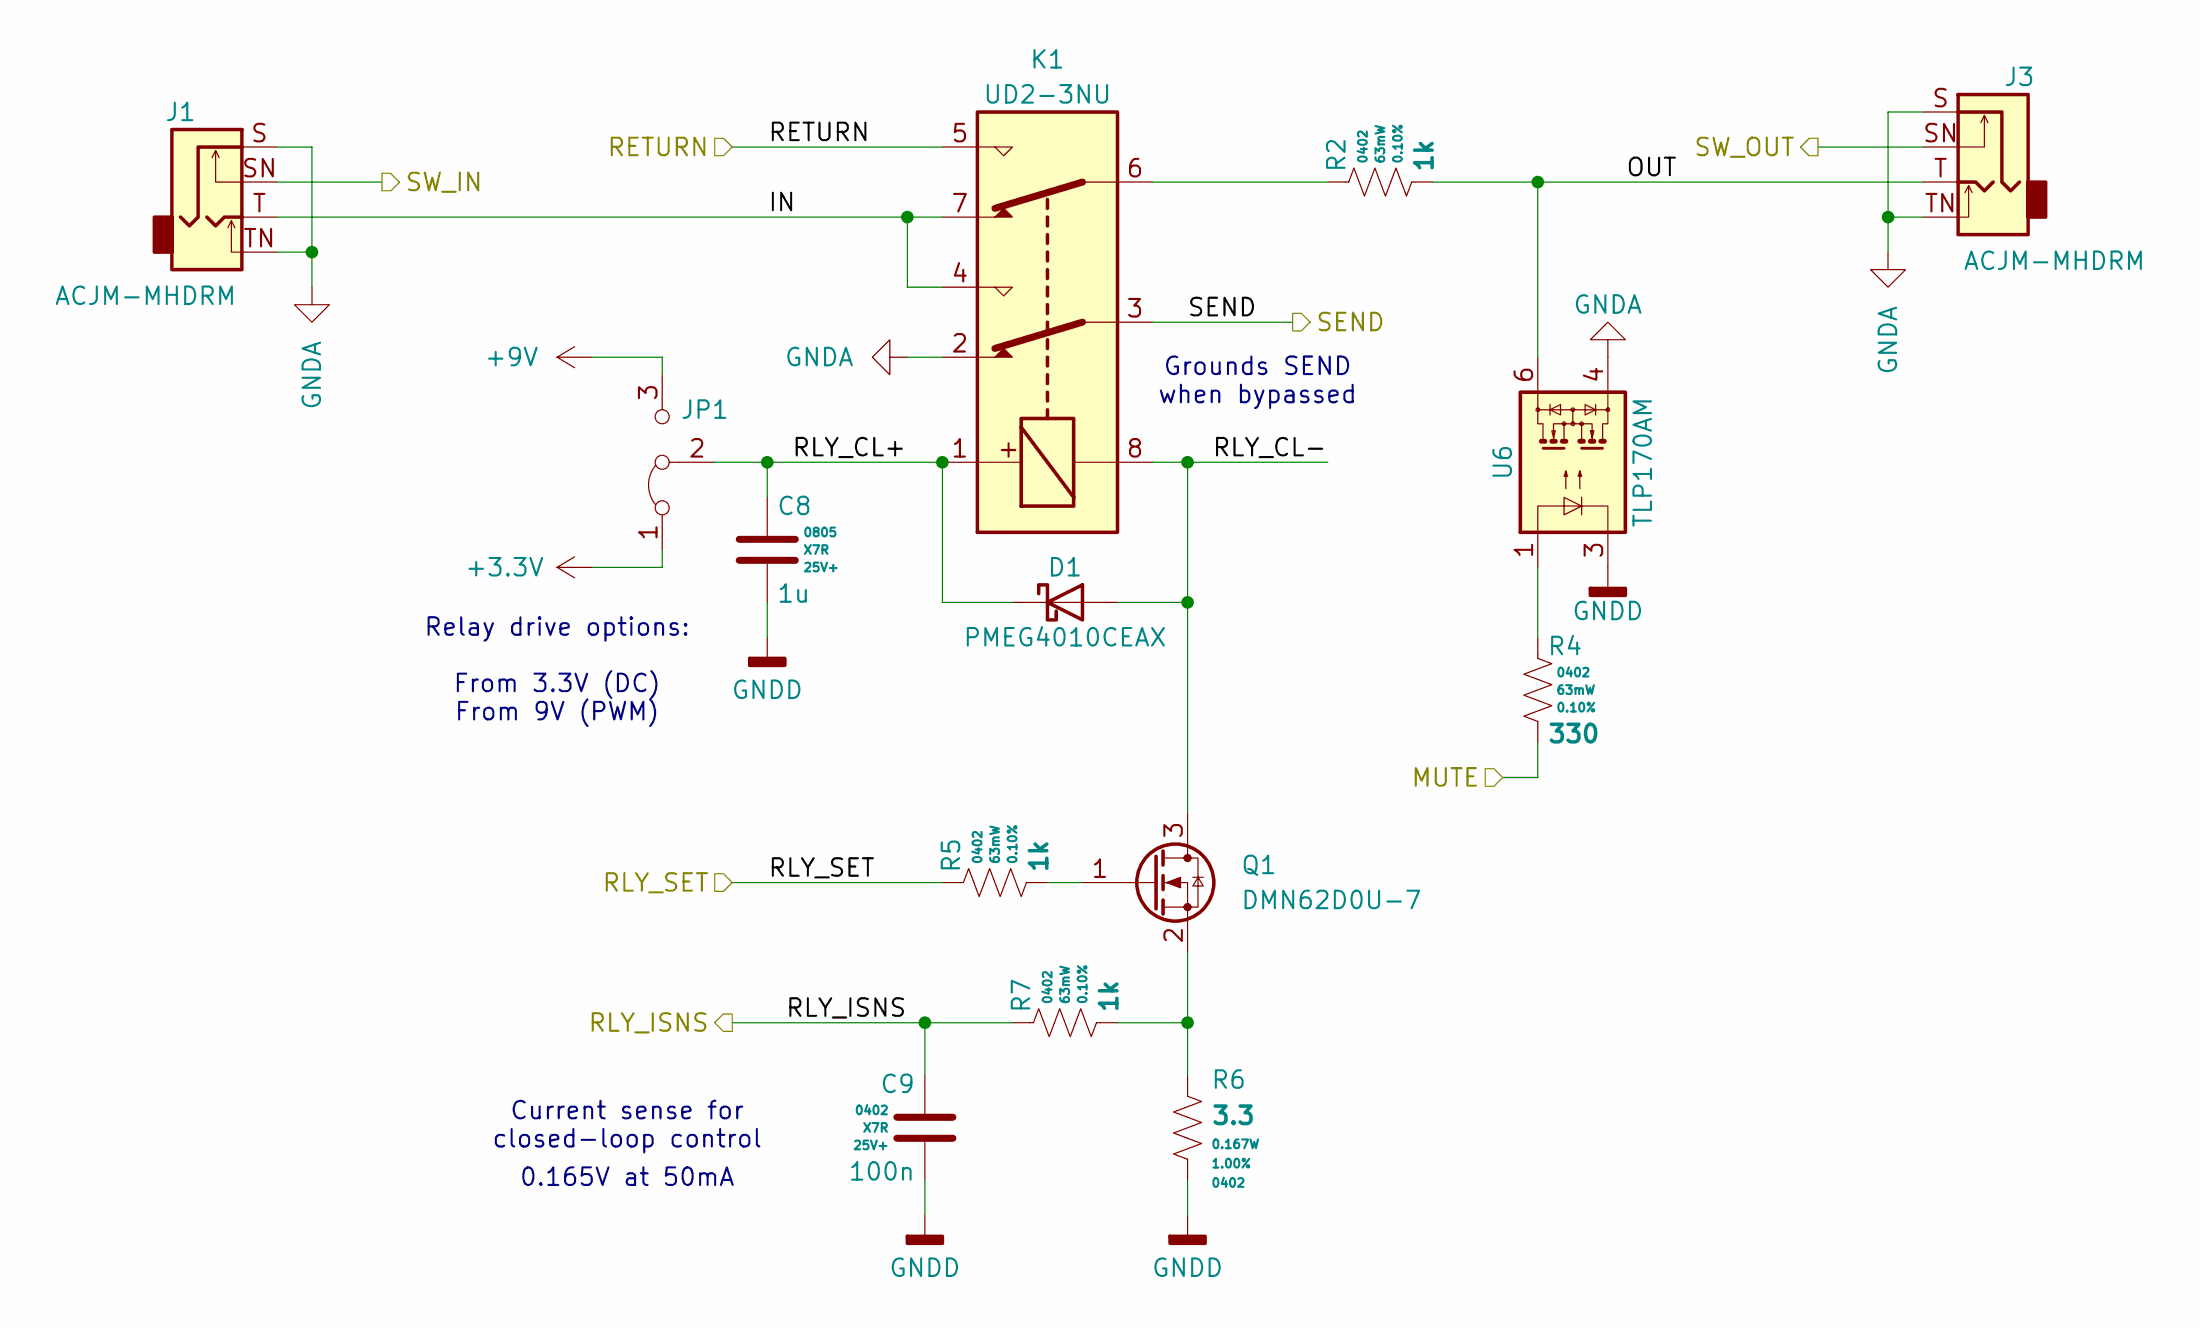
[picture p8: schematic Relay_Jacks.kicad_sch]

Parts:
C8: 1u; C_0805_2012Metric; Voltage 25V+; Tolerance 10%; MPN C0805C105K3RACTU
C9: 100n; C_0402_1005Metric; Voltage 25V+; Tolerance 10%; MPN C0402C104K3RACTU
D1: PMEG4010CEAX; D_SOD-323; Voltage 840 mV @ 1 A; MPN PMEG4010CEAX
J1, J3: 4; Amphenol_ACJM-MHDR(M); MPN ACJM-MHDRM
JP1: Jumper_3_Bridged12; SolderJumper-3_P1.3mm_Bridged12_Pad1.0x1.5mm
K1: IM05JR; UD23NU; MPN UD2-3NU
Q1: DMN62D0U-7; SOT-23; MPN DMN62D0U-7
R2, R5, R7: 1k; R_0402_1005Metric; Tolerance 0.10%; Voltage 50V; MPN RT0402BRD071KL
R4: 330; R_0402_1005Metric; Tolerance 0.10%; Voltage 50V; MPN RT0402BRD07330RL
R6: 3.3; R_0402_1005Metric; Tolerance 1.00%; Voltage 50V; MPN RL0510S-3R3-F
U6: TLP170AM; SO-4_4.4x3.9mm_P2.54mm; MPN TLP170AM

Connections:
+3.3V: JP1.1 (A); also elsewhere on the board
+9V: JP1.3 (B); also elsewhere on the board
/ISNS: C9.1, R7.1; also elsewhere on the board
/MUTE: R4.2; also elsewhere on the board
/RLY_SET: R5.1; also elsewhere on the board
/Relay_And_Jacks/IN: J1.T, K1.4, K1.7
/Relay_And_Jacks/OUT: J3.T, R2.2, U6.6
/Relay_And_Jacks/RETURN: K1.5; also elsewhere on the board
/Relay_And_Jacks/RLY_CL+: C8.1, D1.1 (K), JP1.2 (C), K1.1
/Relay_And_Jacks/RLY_CL-: D1.2 (A), K1.8, Q1.3 (D)
/Relay_And_Jacks/SEND: K1.3; also elsewhere on the board
/SW_IN: J1.SN; also elsewhere on the board
/SW_OUT: J3.SN; also elsewhere on the board
GNDA: J1.S, J1.TN, J3.S, J3.TN, K1.2, U6.4; also elsewhere on the board
GNDD: C8.2, C9.2, R6.2, U6.3; also elsewhere on the board
unnamed: K1.6, R2.1
unnamed: Q1.1 (G), R5.2
unnamed: Q1.2 (S), R6.1, R7.2
unnamed: R4.1, U6.1

Notes on the sheet:
Current sense for closed-loop control
Grounds SEND when bypassed
Relay drive options: From 3.3V (DC) From 9V (PWM)
0.165V at 50mA

Board: 2 copper layers, 60 parts (4 on the bottom side), 41 nets, no tracks yet.
