jer-lil/relay-bypass/(commit log)

2025-05-29 First commit, schematic ready for review + layout
    [3V_Buck.kicad_sch, relay-bypass.kicad_pcb, relay-bypass.kicad_sch]
2025-07-13 Added audio jacks based on recent decision
    Decided to make this a board that mounts to audio jacks on top face of a 125B enclosure. May also work for 1590B, TBD. Made most of the schematic changes.
    [LDO_3V.kicad_sch, Relay_Jacks.kicad_sch, relay-bypass.kicad_sch]
2025-07-17 Schematic done?
    [Relay_Jacks.kicad_sch, relay-bypass.kicad_sch]
2025-09-01 Committing uncommitted work, not sure what it was
    [Relay_Jacks.kicad_sch, relay-bypass.kicad_pcb, relay-bypass.kicad_sch]
2025-09-01 Added second project for exploring a single-jack side mounted version
    [3V_Buck.kicad_sch, LDO_3V.kicad_sch, Relay_Jacks.kicad_sch, relay-bypass-single-jack.kicad_pcb, relay-bypass-single-jack.kicad_sch]
2025-09-29 Pivoted to dual-jack version on opposing sides.
    125B only, using "innie" jacks. Solder-in-place.
    [Relay_Jacks.kicad_sch, relay-bypass-single-jack.kicad_pcb, relay-bypass-single-jack.kicad_sch]
